clacktronics/TBC/hardware/tbc_carrier/bom/tbc_carrier_bom_detailed.csv

Reference | Qty/board | Value | Footprint | Comment | MPN | Manufacturer | LCSC | JLC Library | Stock (2026-10-28) | JLC assembled | Notes | Unit $ (1 pc) | Order qty (5 boards) | Unit $ @ order qty | Line $ (5 boards) | Cost/board $
C1,C3 | 2 | 220p C0G | C_0603_1608Metric | 220pF 50V C0G 5% 0603 | CC0603JRNPO9BN221 | YAGEO | C106210 | Extended | 282194 | yes | No Basic C0G at this value; Basic C1603 is X7R - keep C0G for the video filter | 0.0104 | 20 | 0.0104 | 0.21 | 0.04
C2 | 1 | 680p C0G | C_0603_1608Metric | 680pF 50V C0G 5% 0603 | CC0603JRNPO9BN681 | YAGEO | C107055 | Extended | 1031217 | yes | No Basic C0G at this value | 0.0055 | 20 | 0.0055 | 0.11 | 0.02
C6,C9,C11,C13,C14,C16,C18,C19,C23,C24,C25,C26 | 12 | 100n | C_0603_1608Metric | 100nF 50V X7R 0603 | CC0603KRX7R9BB104 | YAGEO | C14663 | Basic | 39958327 | yes |  | 0.0102 | 70 | 0.0102 | 0.71 | 0.14
C8 | 1 | 1u X7R | C_0603_1608Metric | 1uF 25V X7R 0603 | CL10B105KA8NNNC | Samsung Electro-Mechanics | C29936 | Extended | 816482 | yes | Basic alternative C15849 is X5R | 0.0177 | 20 | 0.0177 | 0.35 | 0.07
C4,C5,C7,C10,C12,C15 | 6 | 10u | C_0805_2012Metric | 10uF 25V X5R 0805 | CL21A106KAYNNNE | Samsung Electro-Mechanics | C15850 | Basic | 8615368 | yes | 25V rating for DC-bias headroom on 5V | 0.0438 | 40 | 0.0438 | 1.75 | 0.35
C17,C20,C21 | 3 | 1u | C_0603_1608Metric | 1uF 50V X5R 0603 | CL10A105KB8NNNC | Samsung Electro-Mechanics | C15849 | Basic | 12815095 | yes |  | 0.0146 | 25 | 0.0146 | 0.36 | 0.07
C22 | 1 | 510p C0G | C_0603_1608Metric | 510pF 50V C0G 5% 0603 | CC0603JRNPO9BN511 | YAGEO | C107052 | Extended | 16228 | yes | No Basic C0G at this value | 0.0075 | 20 | 0.0075 | 0.15 | 0.03
D1,D2 | 2 | PESD5V0S1BB | D_SOD-523 | PESD5V0S1BB,115 | PESD5V0S1BB,115 | Nexperia | C97640 | Extended | 21606 | yes | Nexperia original | 0.1058 | 16 | 0.1058 | 1.69 | 0.34
FB1 | 1 | 600R@100MHz | L_0603_1608Metric | 600R@100MHz 0603 ferrite | GZ1608D601TF | Sunlord | C1002 | Basic | 665333 | yes |  | 0.0115 | 20 | 0.0115 | 0.23 | 0.05
J1 | 1 | RCA (BOOMELE AV-5) | RCA_BOOMELE_AV-5_Horizontal | AV-5 RCA jack yellow | AV-5 | BOOMELE(Boom Precision Elec) | C18080 | Extended | 3231 | yes | Replaces Same Sky RCJ-04x; footprint TBC:RCA_BOOMELE_AV-5_Horizontal | 0.1358 | 6 | 0.1358 | 0.81 | 0.16
J2 | 2 | TangNano20K | TangNano20K_Socket | 1x20 female header 2.54mm H8.5 | KH-2.54FH-1X20P-H8.5 | Shenzhen Kinghelm Elec | C2905423 | Extended | 15110 | no | Needs 2 per board (both rows of J2); one designator can't take 2 parts at JLC, so order separately and hand-solder | 0.2491 | 10 | 0.2491 | 2.49 | 0.50
J3 | 1 | EXP | PinHeader_1x10_P2.54mm_Vertical | 1x10 pin header 2.54mm | PZ254V-11-10P | XFCN | C492409 | Extended | 40938 | yes | THT | 0.0608 | 5 | 0.0608 | 0.30 | 0.06
J4 | 1 | REF IN (RCA) | RCA_BOOMELE_AV-5_Horizontal | AV-5 RCA jack yellow | AV-5 | BOOMELE(Boom Precision Elec) | C18080 | Extended | 3231 | yes | Replaces Same Sky RCJ-04x; footprint TBC:RCA_BOOMELE_AV-5_Horizontal | 0.1358 | 6 | 0.1358 | 0.81 | 0.16
JP2 | 1 | TERM | SolderJumper-2_P1.3mm_Bridged_RoundedPad1.0x1.5mm |  |  |  |  |  |  | no | PCB solder jumper - no part
L1,L2 | 2 | 3.3u | L_1008_2520Metric | 3.3uH 5% 1008 wirewound | NLV25T-3R3J-EFD | TDK | C295353 | Extended | 3253 | yes | TDK NLV25T-3R3J-EFD; no Basic 3.3uH 1008 exists | 0.1111 | 12 | 0.1111 | 1.33 | 0.27
R1,R13 | 2 | 75 1% | R_0603_1608Metric | 75R 1% 0603 | 0603WAF750JT5E | UNI-ROYAL(Uniroyal Elec) | C4275 | Basic | 1599632 | yes |  | 0.0020 | 20 | 0.0020 | 0.04 | 0.01
R3 | 1 | 15k | R_0603_1608Metric | 15k 1% 0603 | 0603WAF1502T5E | UNI-ROYAL(Uniroyal Elec) | C22809 | Basic | 3690827 | yes |  | 0.0029 | 20 | 0.0029 | 0.06 | 0.01
R2,R4,R8 | 3 | 10k | R_0603_1608Metric | 10k 1% 0603 | 0603WAF1002T5E | UNI-ROYAL(Uniroyal Elec) | C25804 | Basic | 38076458 | yes |  | 0.0018 | 25 | 0.0018 | 0.04 | 0.01
R5 | 1 | 1k | R_0603_1608Metric | 1k 1% 0603 | 0603WAF1001T5E | UNI-ROYAL(Uniroyal Elec) | C21190 | Basic | 32882793 | yes |  | 0.0017 | 20 | 0.0017 | 0.03 | 0.01
R6 | 1 | 2k | R_0603_1608Metric | 2k 1% 0603 | 0603WAF2001T5E | UNI-ROYAL(Uniroyal Elec) | C22975 | Basic | 10263678 | yes |  | 0.0024 | 20 | 0.0024 | 0.05 | 0.01
R7 | 1 | 22 | R_0603_1608Metric | 22R 1% 0603 | 0603WAF220JT5E | UNI-ROYAL(Uniroyal Elec) | C23345 | Basic | 6919290 | yes |  | 0.0017 | 20 | 0.0017 | 0.03 | 0.01
R9 | 1 | 4.3k | R_0603_1608Metric | 4.3k 1% 0603 | 0603WAF4301T5E | UNI-ROYAL(Uniroyal Elec) | C23159 | Preferred Ext | 201484 | yes |  | 0.0020 | 20 | 0.0020 | 0.04 | 0.01
R10,R11,R12,R16,R17,R18,R19,R20,R21,R22,R23,R24,R25,R26,R27,R28 | 16 | 33 | R_0603_1608Metric | 33R 1% 0603 | 0603WAF330JT5E | UNI-ROYAL(Uniroyal Elec) | C23140 | Basic | 4423041 | yes |  | 0.0024 | 90 | 0.0024 | 0.22 | 0.04
R14 | 1 | 620 | R_0603_1608Metric | 620R 1% 0603 | 0603WAF6200T5E | UNI-ROYAL(Uniroyal Elec) | C23220 | Preferred Ext | 227623 | yes |  | 0.0018 | 20 | 0.0018 | 0.04 | 0.01
R15 | 1 | 680k 1% | R_0603_1608Metric | 680k 1% 0603 | 0603WAF6803T5E | UNI-ROYAL(Uniroyal Elec) | C25822 | Preferred Ext | 1084550 | yes |  | 0.0015 | 20 | 0.0015 | 0.03 | 0.01
U1 | 1 | CBM8051NST6 | SOT-23-6 | CBM8051NST6 | CBM8051NST6 | Corebai Microelectronics | C19274483 | Extended | 2603 | yes | Replaces TI OPA355NA; same SOT-23-6 pinout, pin 5 enable high | 0.9450 | 5 | 0.9450 | 4.72 | 0.94
U2 | 1 | MS9280 | SSOP-28_5.3x10.2mm_P0.65mm | MS9280 | MS9280 | Hangzhou Ruimeng Tech | C1509021 | Extended | 807 | yes | 10 bit AD9280/AD876 pin-compatible; AD9280ARSZRL (C130297) also fits, 8 bit | 1.5444 | 5 | 1.5444 | 7.72 | 1.54
U3 | 1 | LP5907MFX-3.3 | SOT-23-5 | LP5907MFX-3.3/NOPB | LP5907MFX-3.3/NOPB | Texas Instruments | C80670 | Extended | 35011 | yes | TI original | 0.1651 | 7 | 0.1651 | 1.16 | 0.23
U4 | 1 | LM1881 | SOIC-8_3.9x4.9mm_P1.27mm | LM1881M/TR | LM1881M/TR | HGSEMI | C518922 | Extended | 11409 | yes | HGSEMI second source; same pinout and specs as TI LM1881, SOP-8 | 0.6748 | 5 | 0.6748 | 3.37 | 0.67
U5 | 1 | 74LVC3G17 | SSOP-8_2.95x2.8mm_P0.65mm | SN74LVC3G17DCTR | SN74LVC3G17DCTR | Texas Instruments | C18213 | Extended | 6717 | yes |  | 0.6895 | 5 | 0.6895 | 3.45 | 0.69
TOTAL parts |  |  |  |  |  |  |  |  |  |  |  |  |  |  | 32.34 | 6.47
Est. Extended loading fees |  |  |  |  |  |  |  |  |  |  | 13 unique JLC-assembled Extended parts x $3 (one-off per order) |  |  |  | 39.00 | 7.80
