clacktronics/TBC/hardware/tbc_carrier/tbc_carrier_schematic.pdf

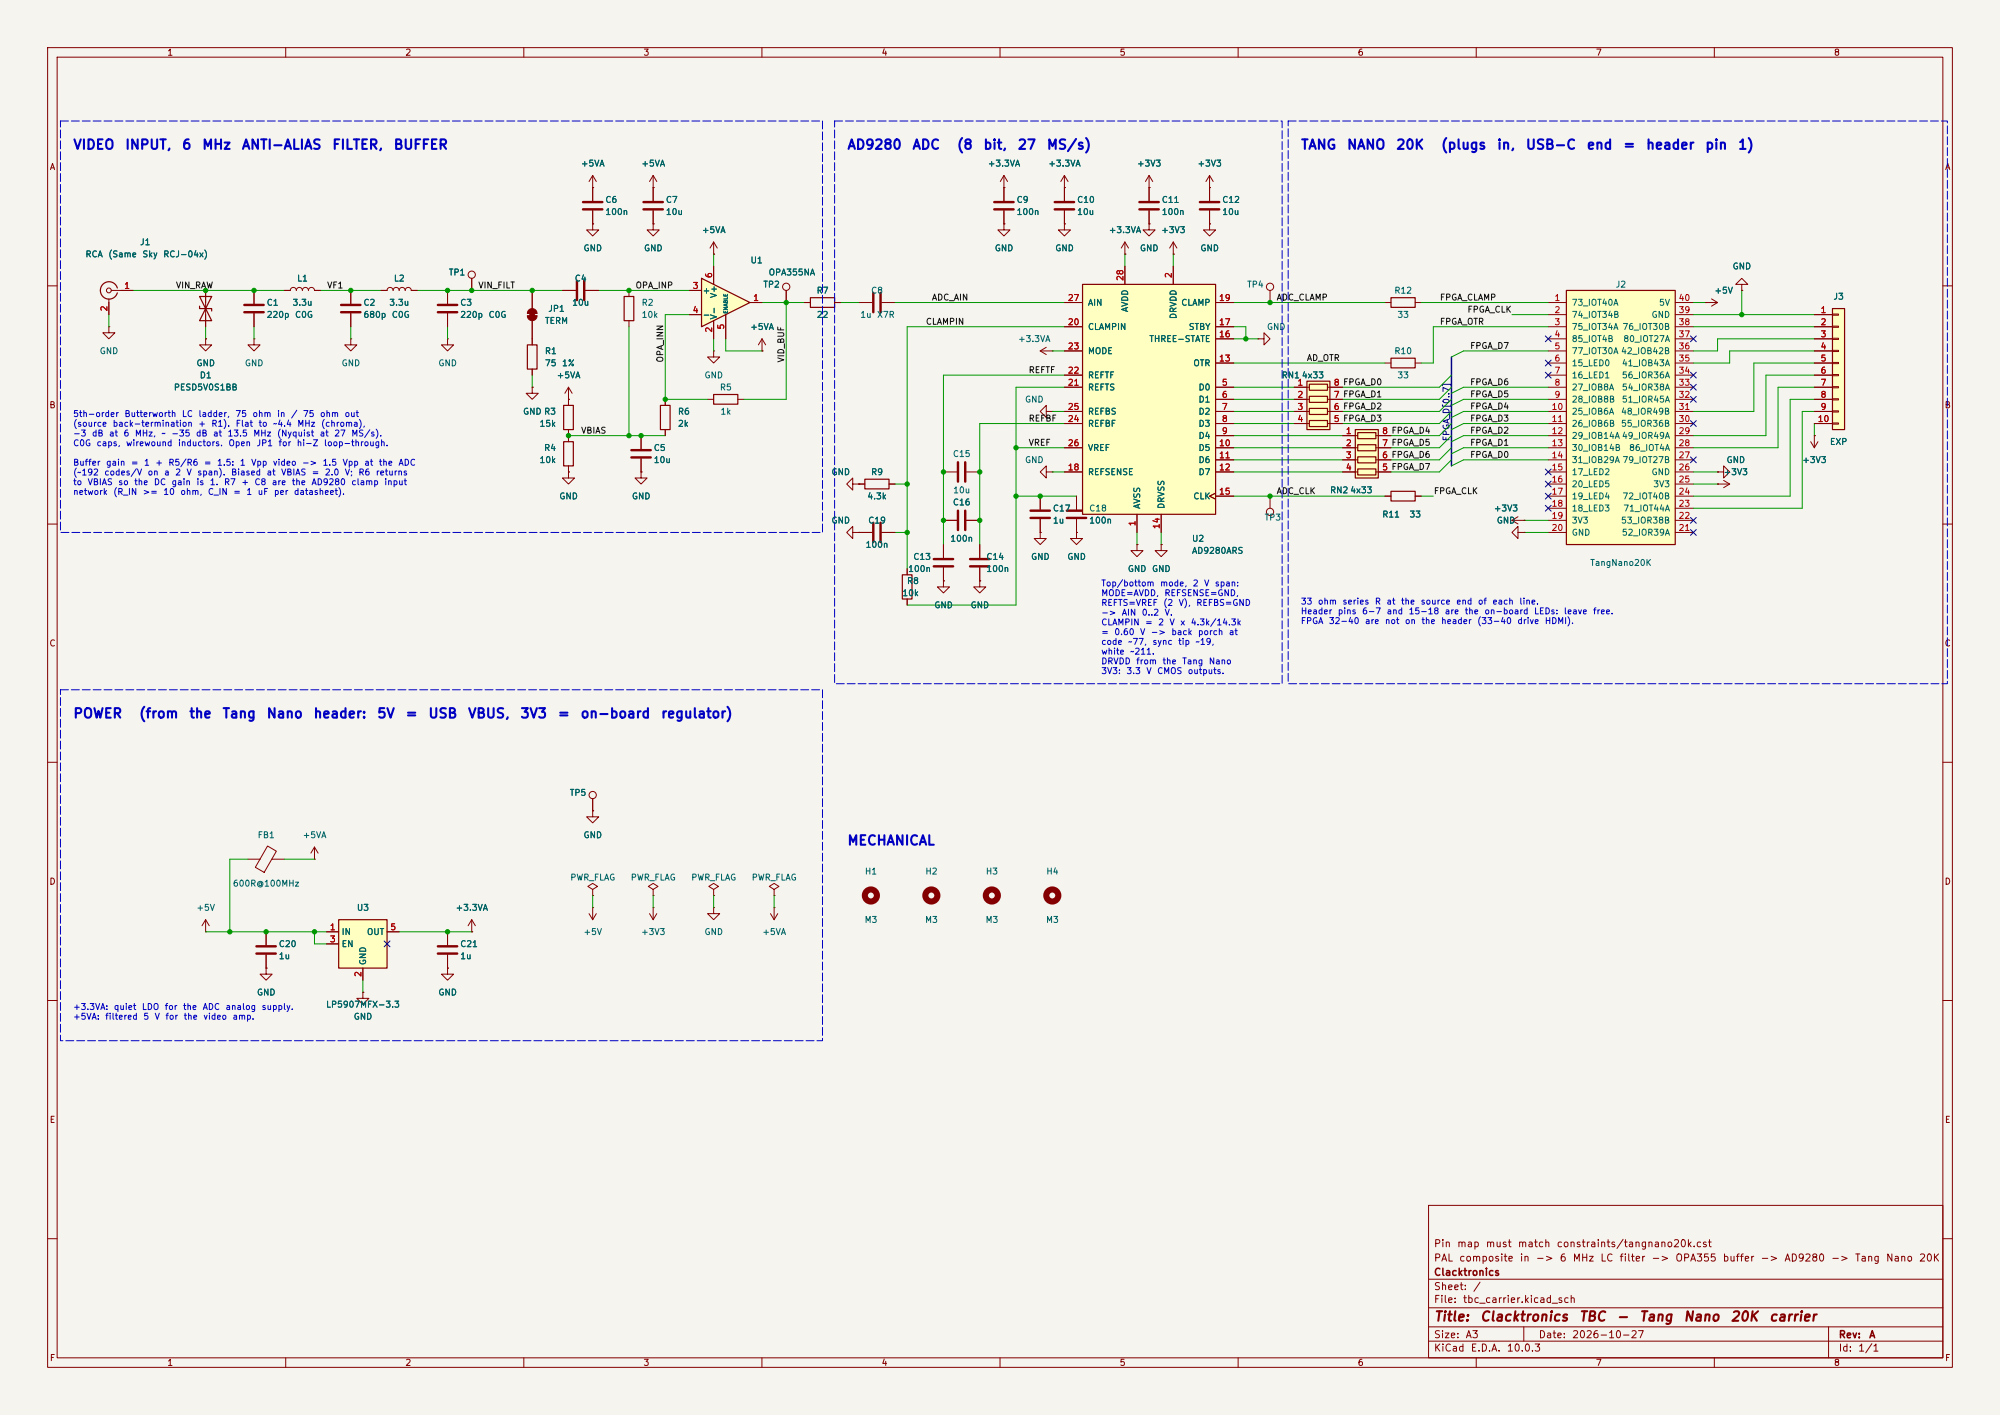
[picture p2: page 1]

J1 RCA (Same Sky RCJ-04x)D1 PESD5V0S1BB

J1 RCA (Same Sky RCJ-04x) 1

5th-order Butterworth LC ladder, 75 ohm in / 75 ohm out (source back-termination + R1). Flat to ~4.4 MHz (chroma), -3 dB at 6 MHz, ~ -35 dB at 13.5 MHz (Nyquist at 27 MS/s). C0G caps, wirewound inductors. Open JP1 for hi-Z loop-through. Buffer gain = 1 + R5/R6 = 1.5: 1 Vpp video -> 1.5 Vpp at the ADC

VREF REFBF | VREF 26

2 2
3 3

(~192 codes/V on a 2 V span). Biased at VBIAS = 2.0 V; R6 returns

Top/bottom mode, 2 V span: MODE=AVDD, REFSENSE=GND, REFTS=VREF (2 V), REFBS=GND -> AIN 0..2 V. CLAMPIN = 2 V x 4.3k/14.3k = 0.60 V -> back porch at code ~77, sync tip ~19, white ~211. DRVDD from the Tang Nano 3V3: 3.3 V CMOS outputs.

POWER (from the Tang Nano header: 5V = USB VBUS, 3V3 = on-board regulator) +3.3VA: quiet LDO for the ADC analog supply. +5VA: filtered 5 V for the video amp.

Pin map must match constraints/tangnano20k.cst
PAL composite in -> 6 MHz LC filter -> OPA355 buffer -> AD9280 -> Tang Nano 20K
Clacktronics
Sheet: /
File: tbc_carrier.kicad_sch
Title: Clacktronics TBC - Tang Nano 20K carrier

Size: A3 | Rev: A
KiCad E.D.A. 10.0.3 | Id: 1/1 | F Date: 2026-10-27
