clacktronics/TBC/hardware/tbc_carrier/tbc_carrier.kicad_pcb

## KiCad design hardware/tbc_carrier/tbc_carrier.kicad_pcb (2026-11-06)

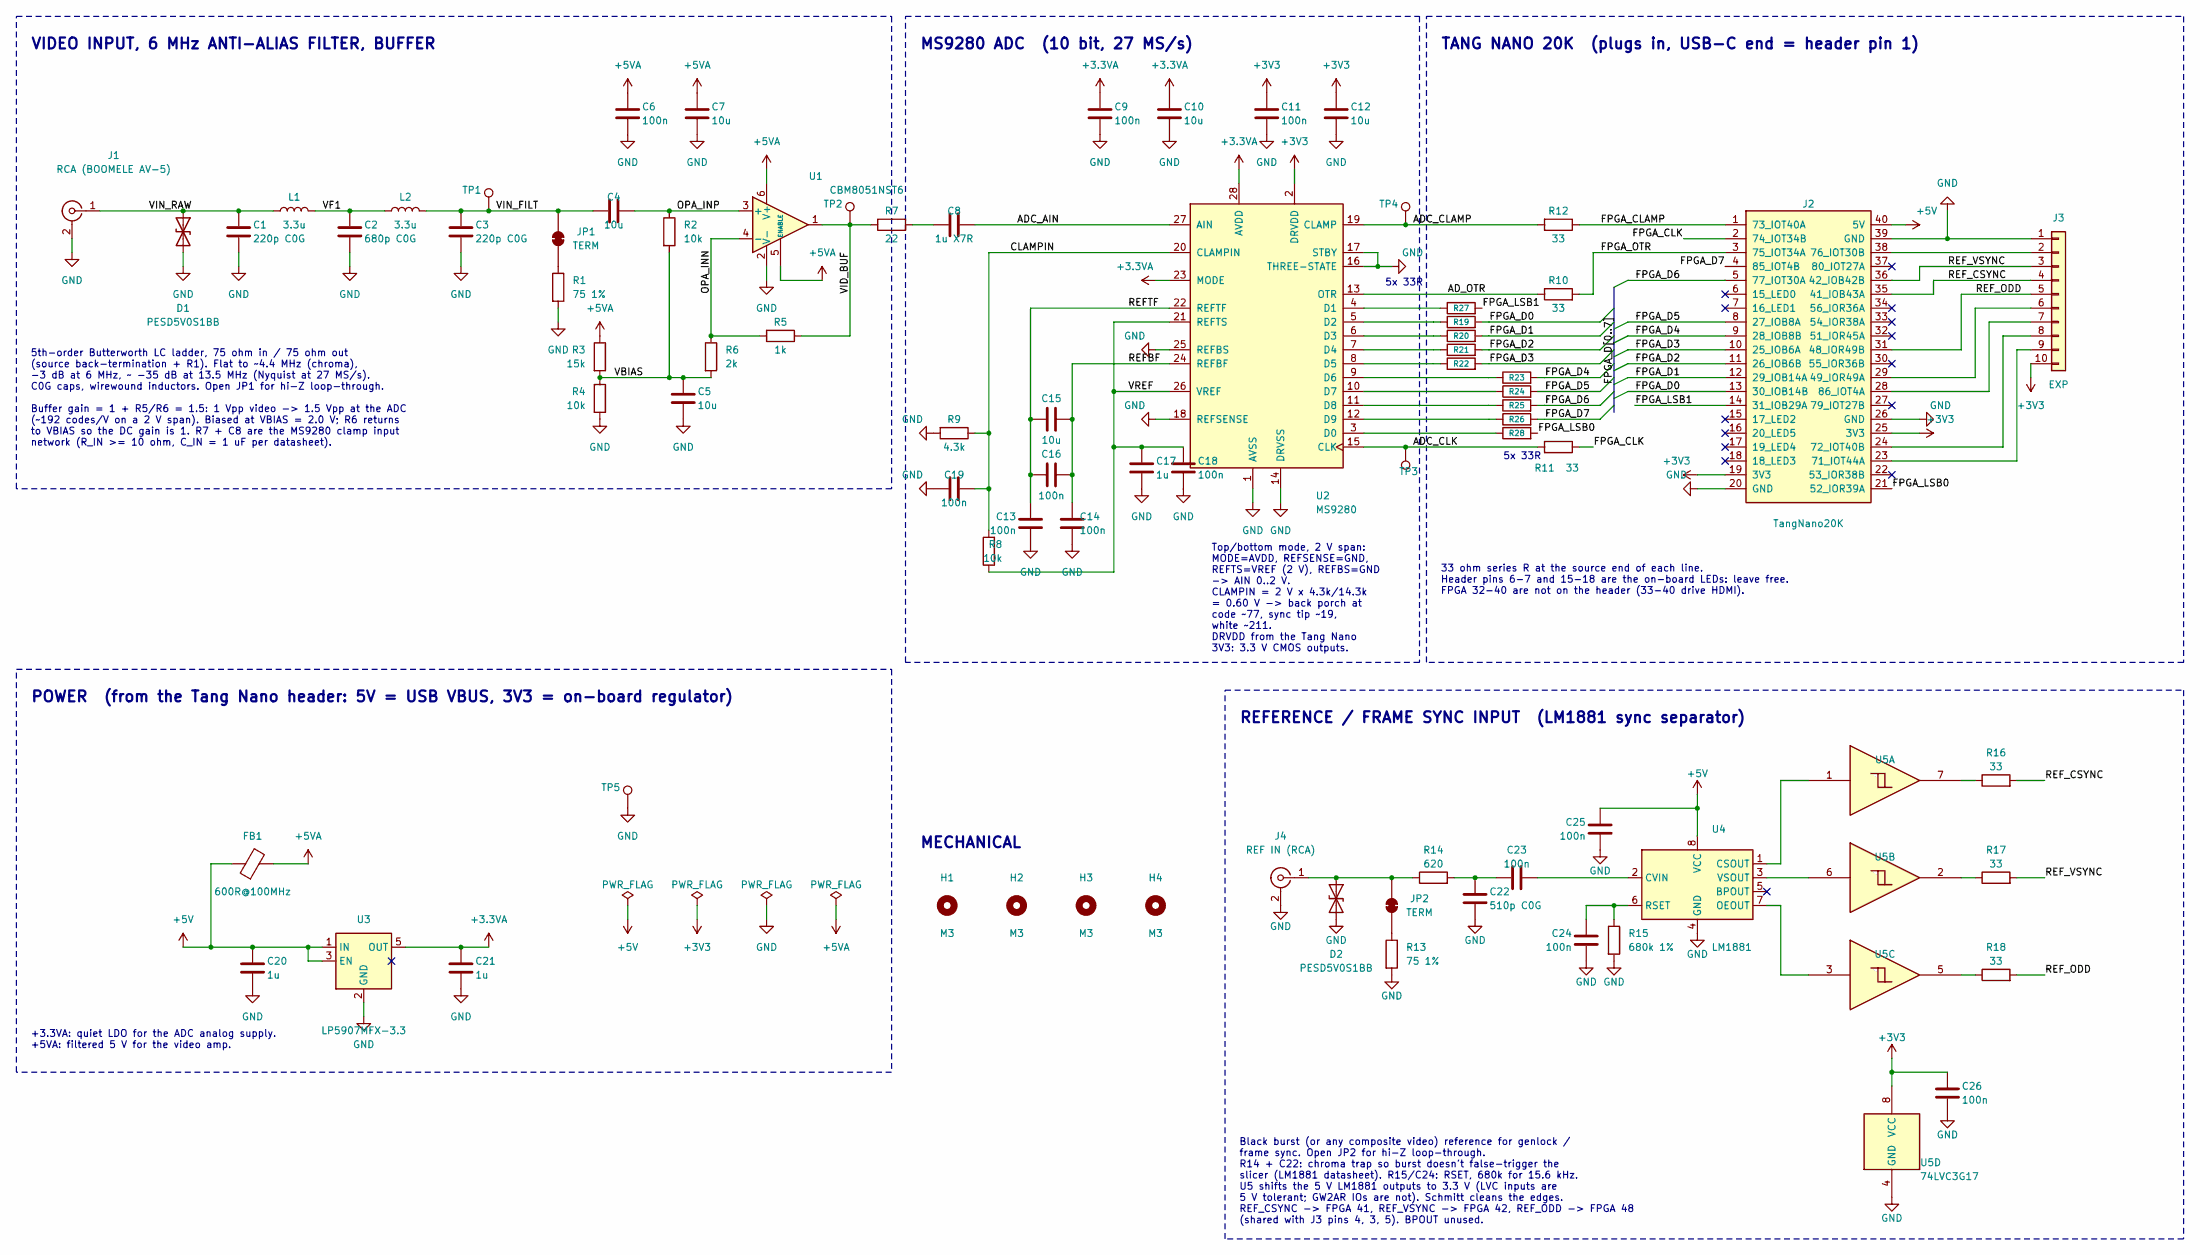
[picture p3: schematic tbc_carrier.kicad_sch, Clacktronics TBC - Tang Nano 20K carrier]

Parts:
C1, C3: 220p C0G; C_0603_1608Metric; MPN CC0603JRNPO9BN221; LCSC C106210
C2: 680p C0G; C_0603_1608Metric; MPN CC0603JRNPO9BN681; LCSC C107055
C4, C5, C7, C10, C12, C15: 10u; C_0805_2012Metric; MPN CL21A106KAYNNNE; LCSC C15850
C6, C9, C11, C13, C14, C16, C18, C19, C23, C24, C25, C26: 100n; C_0603_1608Metric; MPN CC0603KRX7R9BB104; LCSC C14663
C8: 1u X7R; C_0603_1608Metric; MPN CL10B105KA8NNNC; LCSC C29936
C17, C20, C21: 1u; C_0603_1608Metric; MPN CL10A105KB8NNNC; LCSC C15849
C22: 510p C0G; C_0603_1608Metric; MPN CC0603JRNPO9BN511; LCSC C107052
D1, D2: PESD5V0S1BB; D_SOD-523; MPN PESD5V0S1BB,115; LCSC C97640
FB1: 600R@100MHz; L_0603_1608Metric; MPN GZ1608D601TF; LCSC C1002
H1, H2, H3, H4: M3; MountingHole_3.2mm_M3
J1: RCA (BOOMELE AV-5); RCA_BOOMELE_AV-5_Horizontal; MPN AV-5; LCSC C18080
J2: TangNano20K; TangNano20K_Socket; MPN KH-2.54FH-1X20P-H8.5; LCSC C2905423
J3: EXP; PinHeader_1x10_P2.54mm_Vertical; MPN PZ254V-11-10P; LCSC C492409
J4: REF IN (RCA); RCA_BOOMELE_AV-5_Horizontal; MPN AV-5; LCSC C18080
JP1, JP2: TERM; SolderJumper-2_P1.3mm_Bridged_RoundedPad1.0x1.5mm
L1, L2: 3.3u; L_1008_2520Metric; MPN NLV25T-3R3J-EFD; LCSC C295353
R1, R13: 75 1%; R_0603_1608Metric; MPN 0603WAF750JT5E; LCSC C4275
R2, R4, R8: 10k; R_0603_1608Metric; MPN 0603WAF1002T5E; LCSC C25804
R3: 15k; R_0603_1608Metric; MPN 0603WAF1502T5E; LCSC C22809
R5: 1k; R_0603_1608Metric; MPN 0603WAF1001T5E; LCSC C21190
R6: 2k; R_0603_1608Metric; MPN 0603WAF2001T5E; LCSC C22975
R7: 22; R_0603_1608Metric; MPN 0603WAF220JT5E; LCSC C23345
R9: 4.3k; R_0603_1608Metric; MPN 0603WAF4301T5E; LCSC C23159
R10, R11, R12, R16, R17, R18, R19, R20, R21, R22, R23, R24, R25, R26, R27, R28: 33; R_0603_1608Metric; MPN 0603WAF330JT5E; LCSC C23140
R14: 620; R_0603_1608Metric; MPN 0603WAF6200T5E; LCSC C23220
R15: 680k 1%; R_0603_1608Metric; MPN 0603WAF6803T5E; LCSC C25822
TP1, TP2, TP3, TP4, TP5: TestPoint; TestPoint_Pad_D1.5mm
U1: CBM8051NST6; SOT-23-6; MPN CBM8051NST6; LCSC C19274483
U2: MS9280; SSOP-28_5.3x10.2mm_P0.65mm; MPN MS9280; LCSC C1509021
U3: LP5907MFX-3.3; SOT-23-5; MPN LP5907MFX-3.3/NOPB; LCSC C80670
U4: LM1881; SOIC-8_3.9x4.9mm_P1.27mm; MPN LM1881M/TR; LCSC C518922
U5: 74LVC3G17; SSOP-8_2.95x2.8mm_P0.65mm; MPN SN74LVC3G17DCTR; LCSC C18213

Connections:
+3.3VA: C9.1, C10.1, C21.1, U2.23 (MODE), U2.28 (AVDD), U3.5 (OUT)
+3V3: C11.1, C12.1, C26.1, J2.19 (3V3), J2.25 (3V3), J3.10, U2.2 (DRVDD), U5.8 (VCC)
+5V: C20.1, C25.1, FB1.1, J2.40 (5V), U3.1 (IN), U3.3 (EN), U4.8 (VCC)
+5VA: C6.1, C7.1, FB1.2, R3.1, U1.5 (ENABLE), U1.6 (V+)
/ADC_AIN: C8.2, U2.27 (AIN)
/ADC_CLAMP: R12.2, TP4.1 (1_1), U2.19 (CLAMP)
/ADC_CLK: R11.2, TP3.1 (1_1), U2.15 (CLK)
/AD_OTR: R10.1, U2.13 (OTR)
/CLAMPIN: C19.1, R8.2, R9.1, U2.20 (CLAMPIN)
/FPGA_CLAMP: J2.1 (73_IOT40A), R12.1
/FPGA_CLK: J2.2 (74_IOT34B), R11.1
/FPGA_D0: J2.13 (30_IOB14B), R19.2
/FPGA_D1: J2.12 (29_IOB14A), R20.2
/FPGA_D2: J2.11 (26_IOB6B), R21.2
/FPGA_D3: J2.10 (25_IOB6A), R22.2
/FPGA_D4: J2.9 (28_IOB8B), R23.2
/FPGA_D5: J2.8 (27_IOB8A), R24.2
/FPGA_D6: J2.5 (77_IOT30A), R25.2
/FPGA_D7: J2.4 (85_IOT4B), R26.2
/FPGA_LSB0: J2.21 (52_IOR39A), R28.2
/FPGA_LSB1: J2.14 (31_IOB29A), R27.2
/FPGA_OTR: J2.3 (75_IOT34A), R10.2
/OPA_INN: R5.2, R6.1, U1.4 (-)
/OPA_INP: C4.2, R2.1, U1.3 (+)
/REFBF: C14.1, C15.2, C16.2, U2.24 (REFBF)
/REFTF: C13.1, C15.1, C16.1, U2.22 (REFTF)
/REF_CSYNC: J2.35 (41_IOB43A), J3.4, R16.2
/REF_ODD: J2.31 (48_IOR49B), J3.5, R18.2
/REF_VSYNC: J2.36 (42_IOB42B), J3.3, R17.2
/VBIAS: C5.1, R2.2, R3.2, R4.1, R6.2
/VF1: C2.1, L1.2, L2.1
/VID_BUF: R5.1, R7.1, TP2.1 (1_1), U1.1
/VIN_FILT: C3.1, C4.1, JP1.1 (A), L2.2, TP1.1 (1_1)
/VIN_RAW: C1.1, D1.1 (A1), J1.1 (In), L1.1
/VREF: C17.1, C18.1, R8.1, U2.21 (REFTS), U2.26 (VREF)
GND: C1.2, C2.2, C3.2, C5.2, C6.2, C7.2, C9.2, C10.2, C11.2, C12.2, C13.2, C14.2, C17.2, C18.2, C19.2, C20.2, C21.2, C22.2, C24.2, C25.2, C26.2, D1.2 (A2), D2.2 (A2), J1.2 (Ext), J2.20 (GND), J2.26 (GND), J2.39 (GND), J3.1, J4.2 (Ext), R1.2, R4.2, R9.2, R13.2, R15.2, TP5.1 (1_1), U1.2 (V-), U2.1 (AVSS), U2.14 (DRVSS), U2.16 (THREE-STATE), U2.17 (STBY), U2.18 (REFSENSE), U2.25 (REFBS), U3.2 (GND), U4.4 (GND), U5.4 (GND)
unnamed: C8.1, R7.2
unnamed: C22.1, C23.1, R14.2
unnamed: D2.1 (A1), J4.1 (In), JP2.1 (A), R14.1
unnamed: J2.29 (49_IOR49A), J3.6
unnamed: J2.23 (71_IOT44A), J3.9
unnamed: J2.24 (72_IOT40B), J3.8
unnamed: J2.38 (76_IOT30B), J3.2
unnamed: J2.28 (86_IOT4A), J3.7
unnamed: JP1.2 (B), R1.1
unnamed: JP2.2 (B), R13.1
unnamed: R16.1, U5.7
unnamed: R17.1, U5.2
unnamed: R18.1, U5.5
unnamed: R28.1, U2.3 (D0)
unnamed: R27.1, U2.4 (D1)
unnamed: R19.1, U2.5 (D2)
unnamed: R20.1, U2.6 (D3)
unnamed: R21.1, U2.7 (D4)
unnamed: R22.1, U2.8 (D5)
unnamed: R23.1, U2.9 (D6)
unnamed: R24.1, U2.10 (D7)
unnamed: R25.1, U2.11 (D8)
unnamed: R26.1, U2.12 (D9)
unnamed: U4.1 (CSOUT), U5.1
unnamed: C23.2, U4.2 (CVIN)
unnamed: U4.7 (OEOUT), U5.3
unnamed: C24.1, R15.1, U4.6 (RSET)
unnamed: U4.3 (VSOUT), U5.6

Notes on the sheet:
Top/bottom mode, 2 V span: MODE=AVDD, REFSENSE=GND, REFTS=VREF (2 V), REFBS=GND -> AIN 0..2 V. CLAMPIN = 2 V x 4.3k/14.3k = 0.60 V -> back porch at code ~77, sync tip ~19, white ~211. DRVDD from the Tang Nano 3V3: 3.3 V CMOS outputs.
MS9280 ADC (10 bit, 27 MS/s)
VIDEO INPUT, 6 MHz ANTI-ALIAS FILTER, BUFFER
Black burst (or any composite video) reference for genlock / frame sync. Open JP2 for hi-Z loop-through. R14 + C22: chroma trap so burst doesn't false-trigger the slicer (LM1881 datasheet). R15/C24: RSET, 680k for 15.6 kHz. U5 shifts the 5 V LM1881 outputs to 3.3 V (LVC inputs are 5 V tolerant; GW2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
POWER (from the Tang Nano header: 5V = USB VBUS, 3V3 = on-board regulator)
MECHANICAL
REFERENCE / FRAME SYNC INPUT (LM1881 sync separator)
TANG NANO 20K (plugs in, USB-C end = header pin 1)
5th-order Butterworth LC ladder, 75 ohm in / 75 ohm out (source back-termination + R1). Flat to ~4.4 MHz (chroma), -3 dB at 6 MHz, ~ -35 dB at 13.5 MHz (Nyquist at 27 MS/s). C0G caps, wirewound inductors. Open JP1 for hi-Z loop-through. Buffer gain = 1 + R5/R6 = 1.5: 1 Vpp video -> 1.5 Vpp at the A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
33 ohm series R at the source end of each line. Header pins 6-7 and 15-18 are the on-board LEDs: leave free. FPGA 32-40 are not on the header (33-40 drive HDMI).
+3.3VA: quiet LDO for the ADC analog supply. +5VA: filtered 5 V for the video amp.
5x 33R

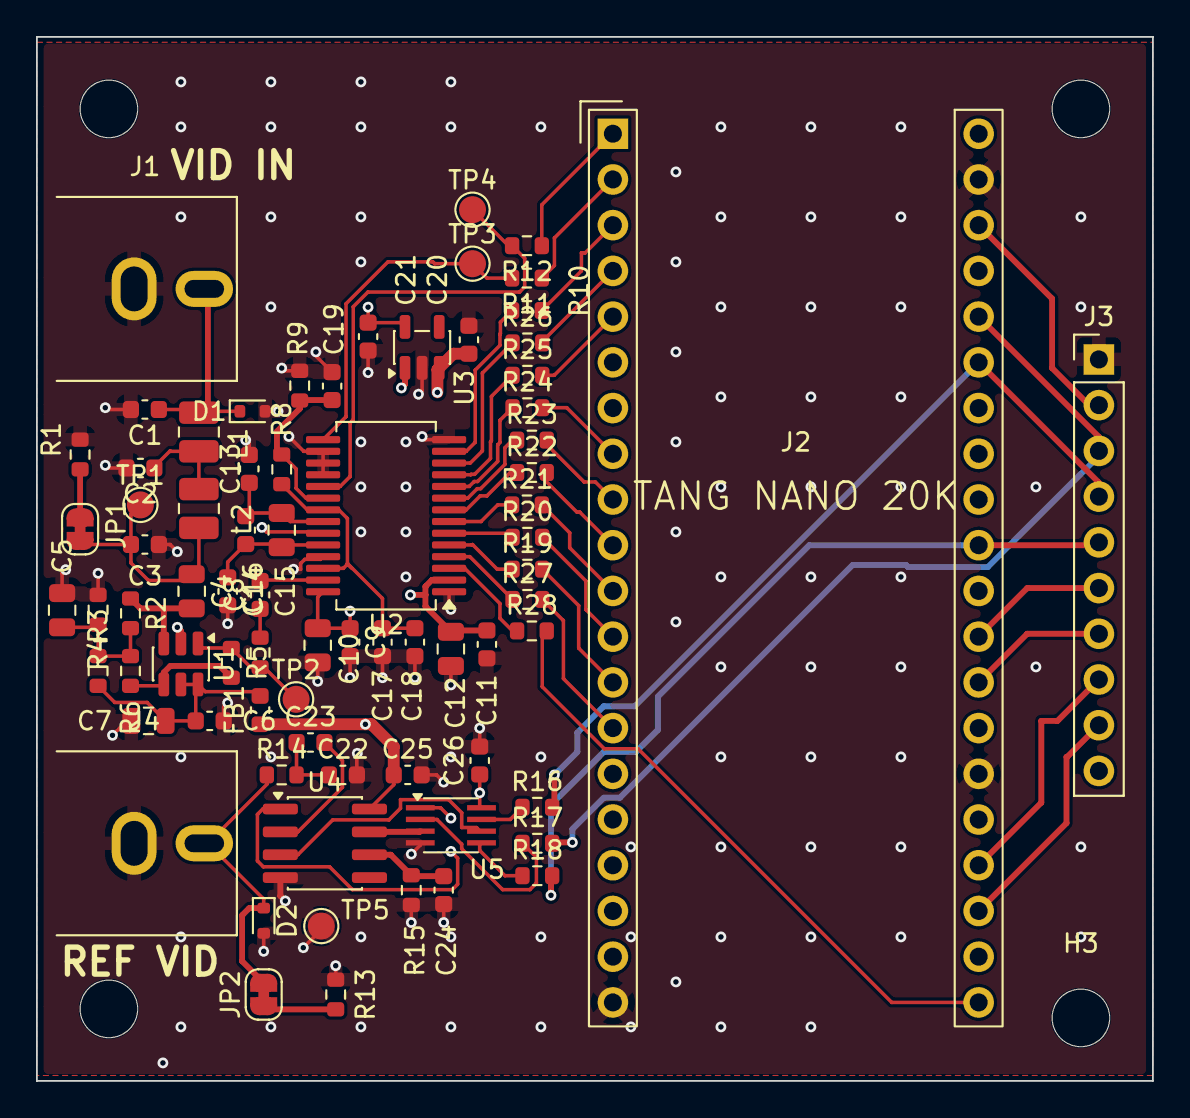
[picture p4: board tbc_carrier.kicad_pcb from above]

Board: 4 copper layers, 62.0 x 58.0 mm, 79 parts (0 on the bottom side), 64 nets.
